vlad-ivanov-name/microphone/docs/dc-dc.png

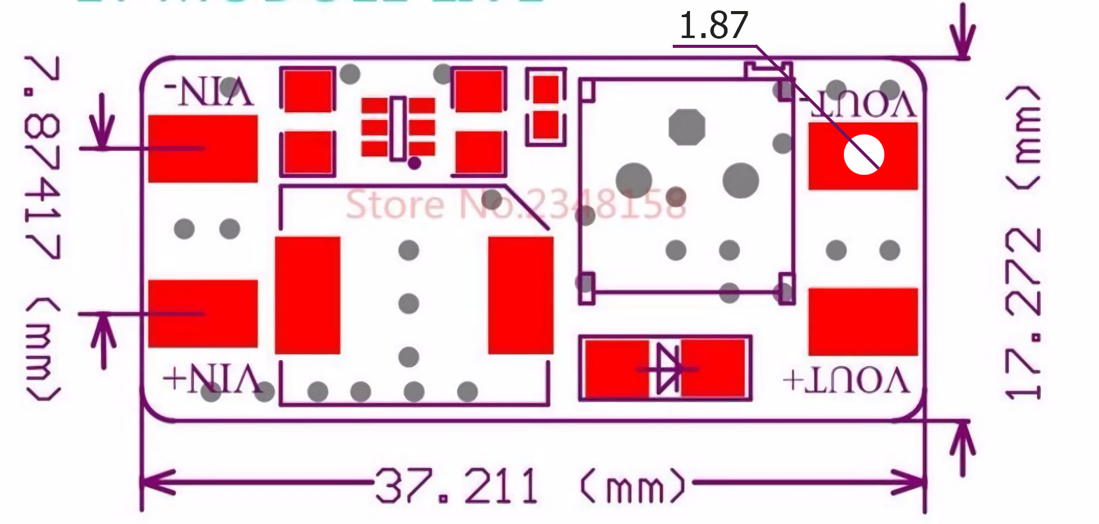
docs/dc-dc.png
