vlad-ivanov-name/microphone/docs/pj324.png

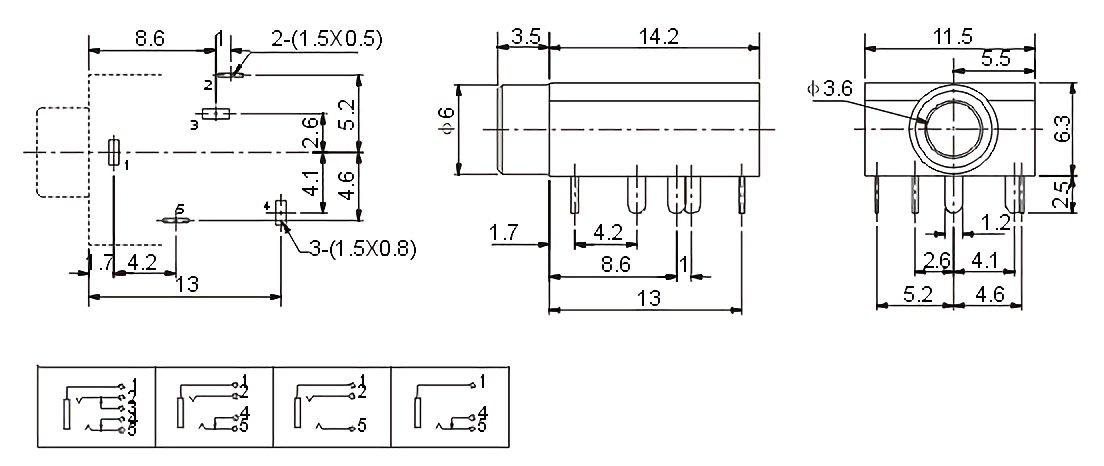
docs/pj324.png
