vlad-ivanov-name/microphone/docs/usb-micro-b.jpg

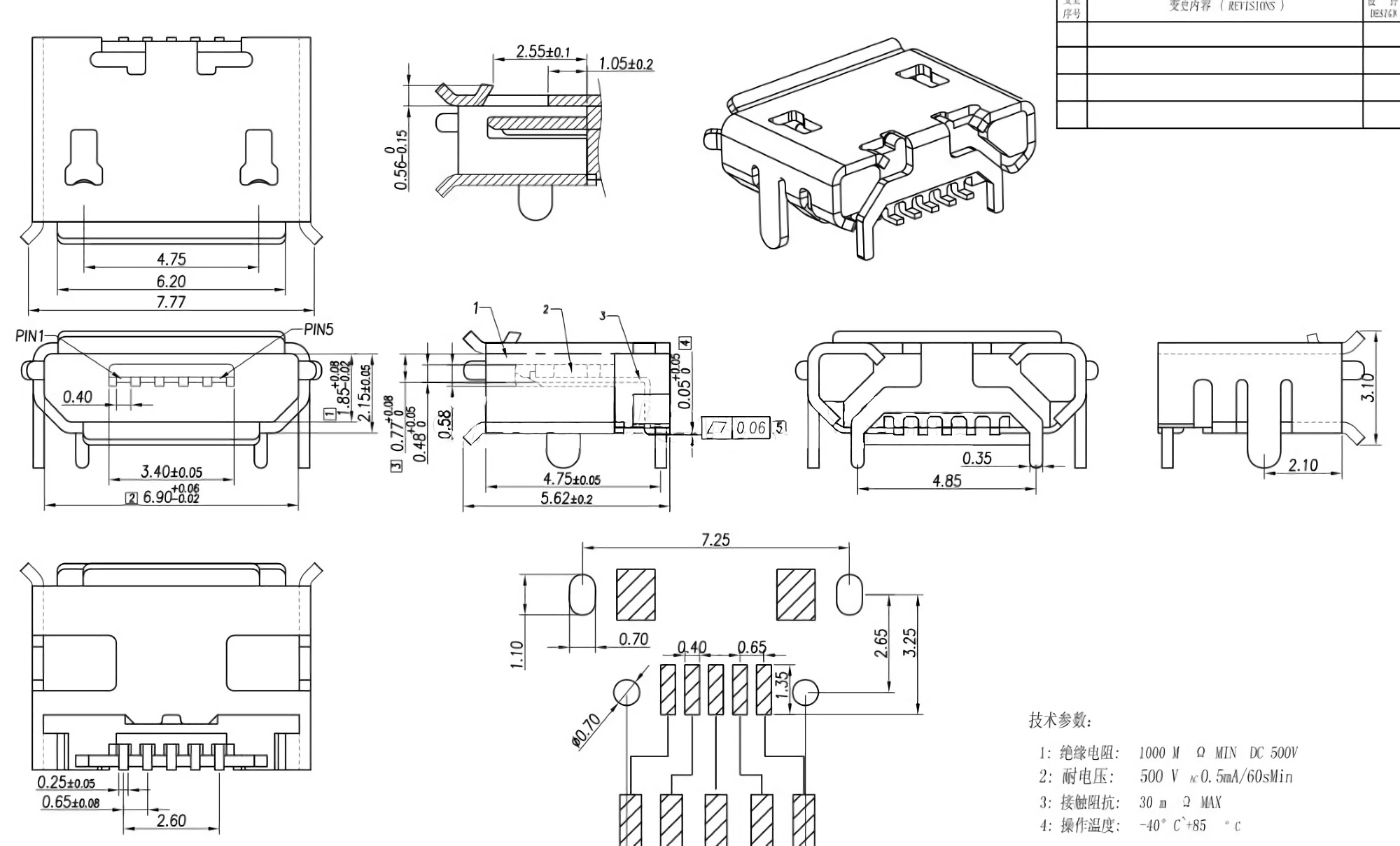
docs/usb-micro-b.jpg
