vlad-ivanov-name/microphone/preamp.kicad_pcb

## KiCad design preamp.kicad_pcb (2017-04-08)

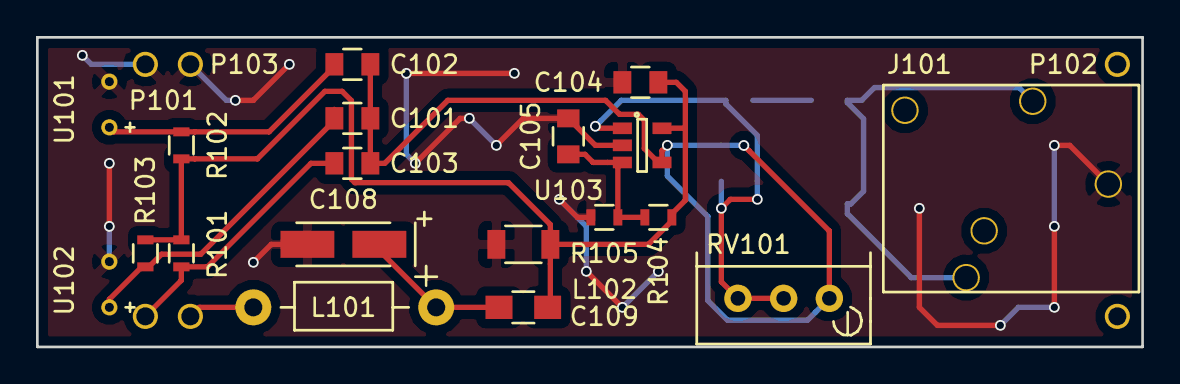
[picture p7: board preamp.kicad_pcb from above]

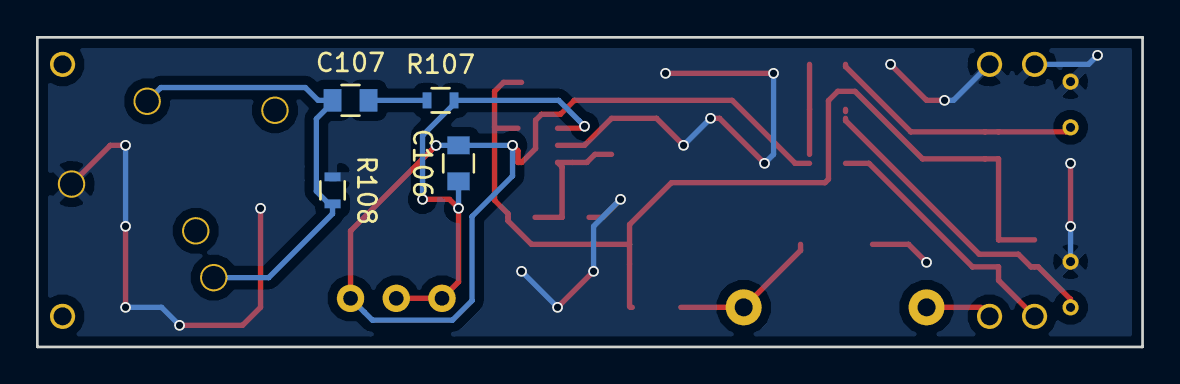
[picture p8: board preamp.kicad_pcb from below]

Board: 2 copper layers, 61.4 x 17.2 mm, 26 parts (4 on the bottom side), 12 nets.

Parts:
C101, C102, C103, C105, C107: 2.2u; C_0805
C104: 10n; C_0805
C106: 16p; C_0805
C108: 10u; TantalC_SizeA_EIA-3216_HandSoldering
C109: 100n; C_1206
J101: PJ-324
L101: 470uH; Choke_Horizontal_RM10mm
L102: FILTER; R_0805_HandSoldering
P101, P102, P103: CONN_01X02; BOARD-CONNECT
R101, R102, R103: 14k; R_0603
R104, R105, R108: 100k; R_0603
R107: 50; R_0603
RV101: 100k; Potentiometer_Bourns_3296W_3-8Zoll_Inline_ScrewUp
U101, U102: CMIC
U103: OPA172; SOT-23-5

Connections:
+9V: C104.2, C109.1, L102.2, R101.1, R102.1, R103.1, R104.2, U103.5
GND: C104.1, C105.2, C108.2, C109.2, J101.1, P101.1, P103.1, R105.1, R108.1, U101.2, U102.2, U103.2
unnamed: C101.1, C102.1, C103.1, C106.2, RV101.1, U103.4
unnamed: C101.2, R103.2, U102.1
unnamed: C102.2, R102.2, U101.1
unnamed: C103.2, P101.2, R101.2
unnamed: C105.1, R104.1, R105.2, U103.3
unnamed: C106.1, R107.2, RV101.2, RV101.3, U103.1
unnamed: C107.1, J101.2, J101.5, R108.2
unnamed: C107.2, R107.1
unnamed: C108.1, L101.2, L102.1
unnamed: L101.1, P103.2
