vlad-ivanov-name/microphone/preamp-power.kicad_pcb

## KiCad design preamp-power.kicad_pcb (2017-04-08)

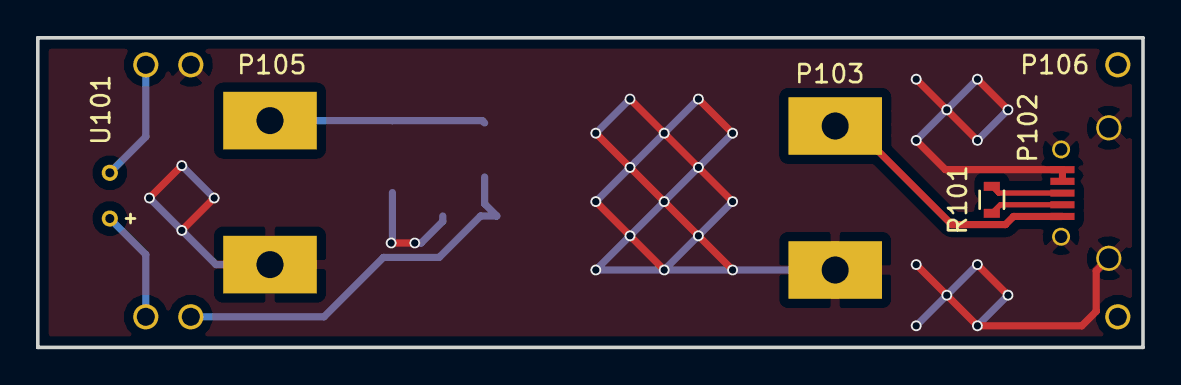
[picture p9: board preamp-power.kicad_pcb from above]

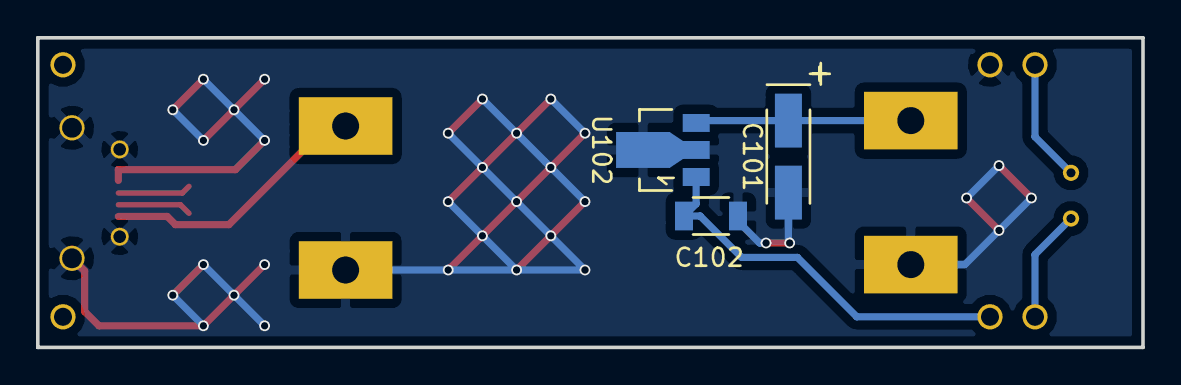
[picture p10: board preamp-power.kicad_pcb from below]

Board: 2 copper layers, 61.4 x 17.2 mm, 11 parts (3 on the bottom side), 8 nets.

Parts:
C101: 10u; TantalC_SizeA_EIA-3216_HandSoldering
C102: 100n; C_1206
P101, P104, P106: CONN_01X02; BOARD-CONNECT
P102: USB_OTG; USB-MICRO-B
P103, P105: CONN_01X02; BOARD-CONNECT-DCDC
R101: 0; R_0603
U101: CMIC
U102: 78L09; SOT89-3_Housing

Connections:
+12V: C101.1, P105.1, U102.3
GND: C101.2, C102.2, P102.4, P102.5, P102.6, P103.2, P104.2, P105.2, U102.2
unnamed: C102.1, P104.1, U102.1
unnamed: P101.1, U101.1
unnamed: P101.2, U101.2
unnamed: P102.1, P103.1
unnamed: P102.2, R101.1
unnamed: P102.3, R101.2
