vlad-ivanov-name/microphone/(commit log)

2017-04-08 Add gerbmerge config and makefile
    [gerbmerge.cfg]
2017-04-08 Add DNP to USB data resestor
    [preamp-power.sch]
2017-04-08 Fix libraries
    [preamp.sch]
